esophagus-now/fpga-bpf/Reference/Figures/BPF CPU Datapath.png

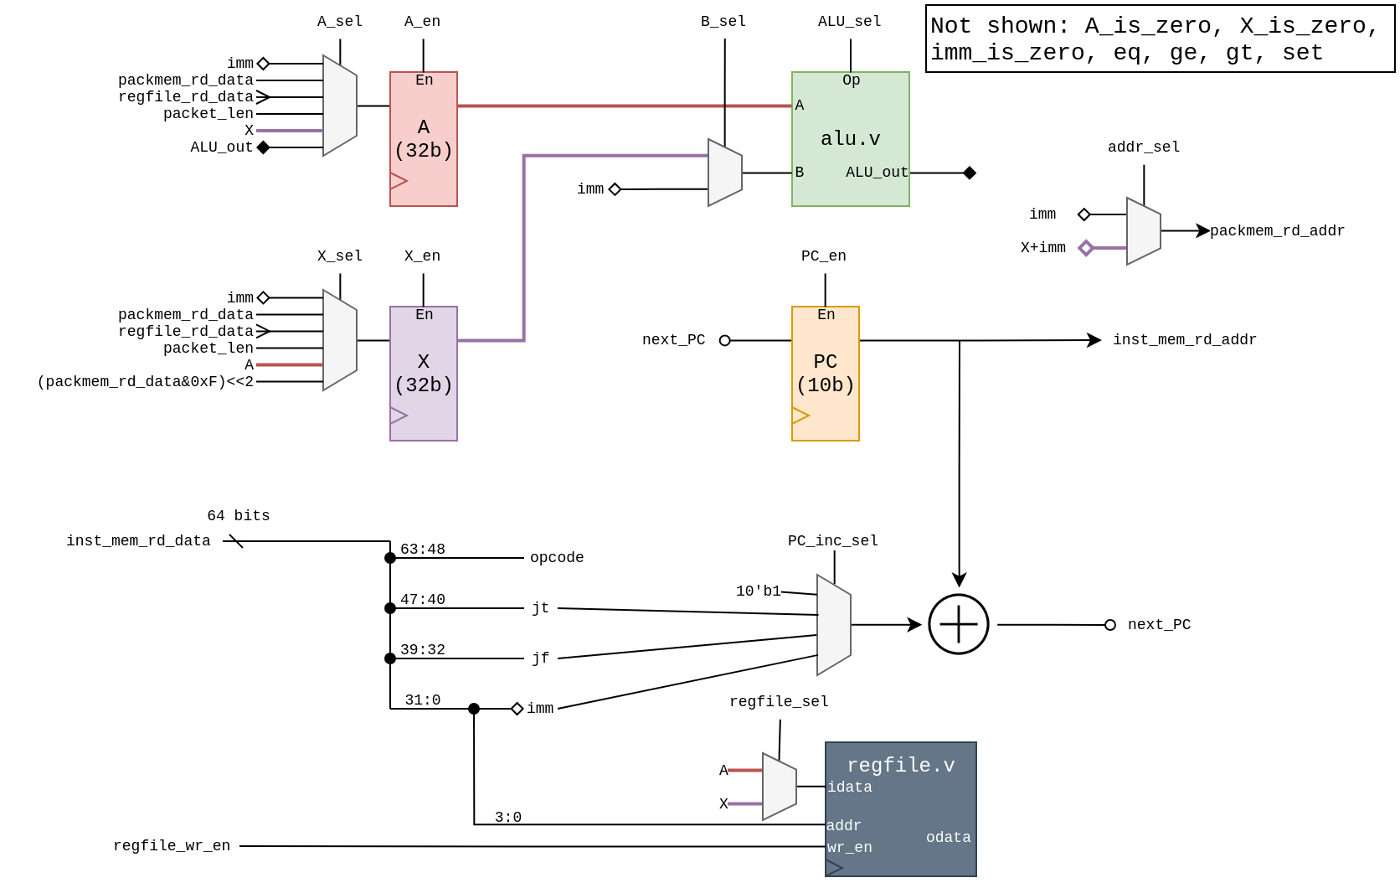
Reference/Figures/BPF CPU Datapath.png
