esophagus-now/fpga-bpf/Reference/Figures/BPF CPU State diagram.png

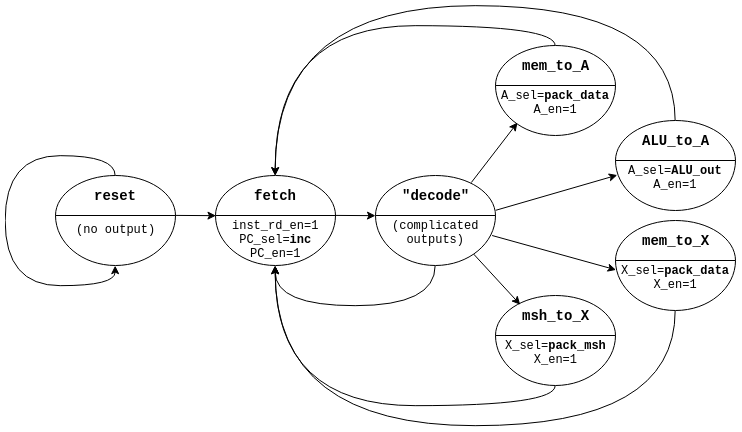
Reference/Figures/BPF CPU State diagram.png
