esophagus-now/fpga-bpf/Reference/Figures/Channel-level pipeline.png

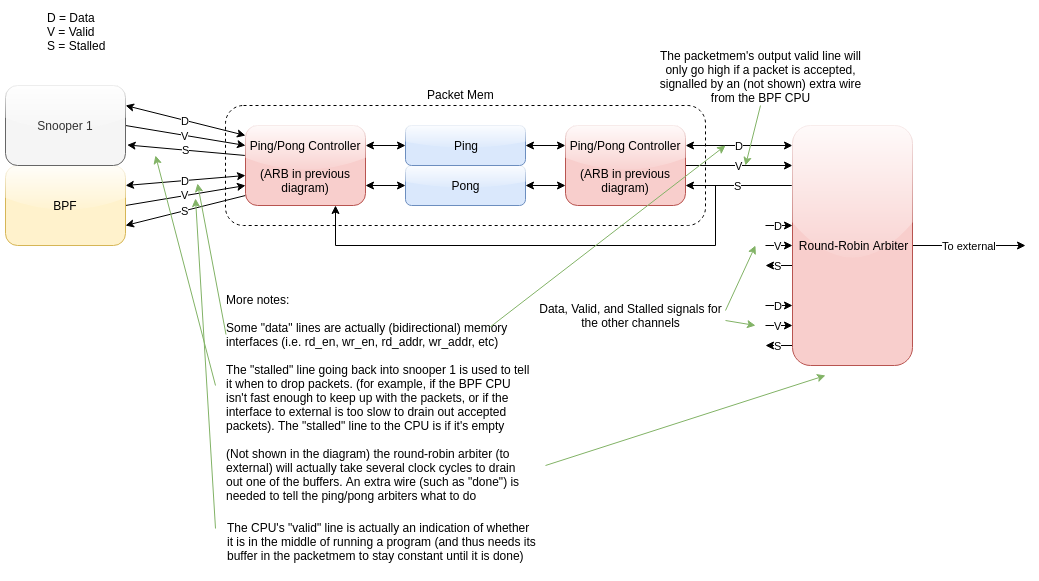
Reference/Figures/Channel-level pipeline.png
