esophagus-now/fpga-bpf/Reference/Figures/Job Queues.png

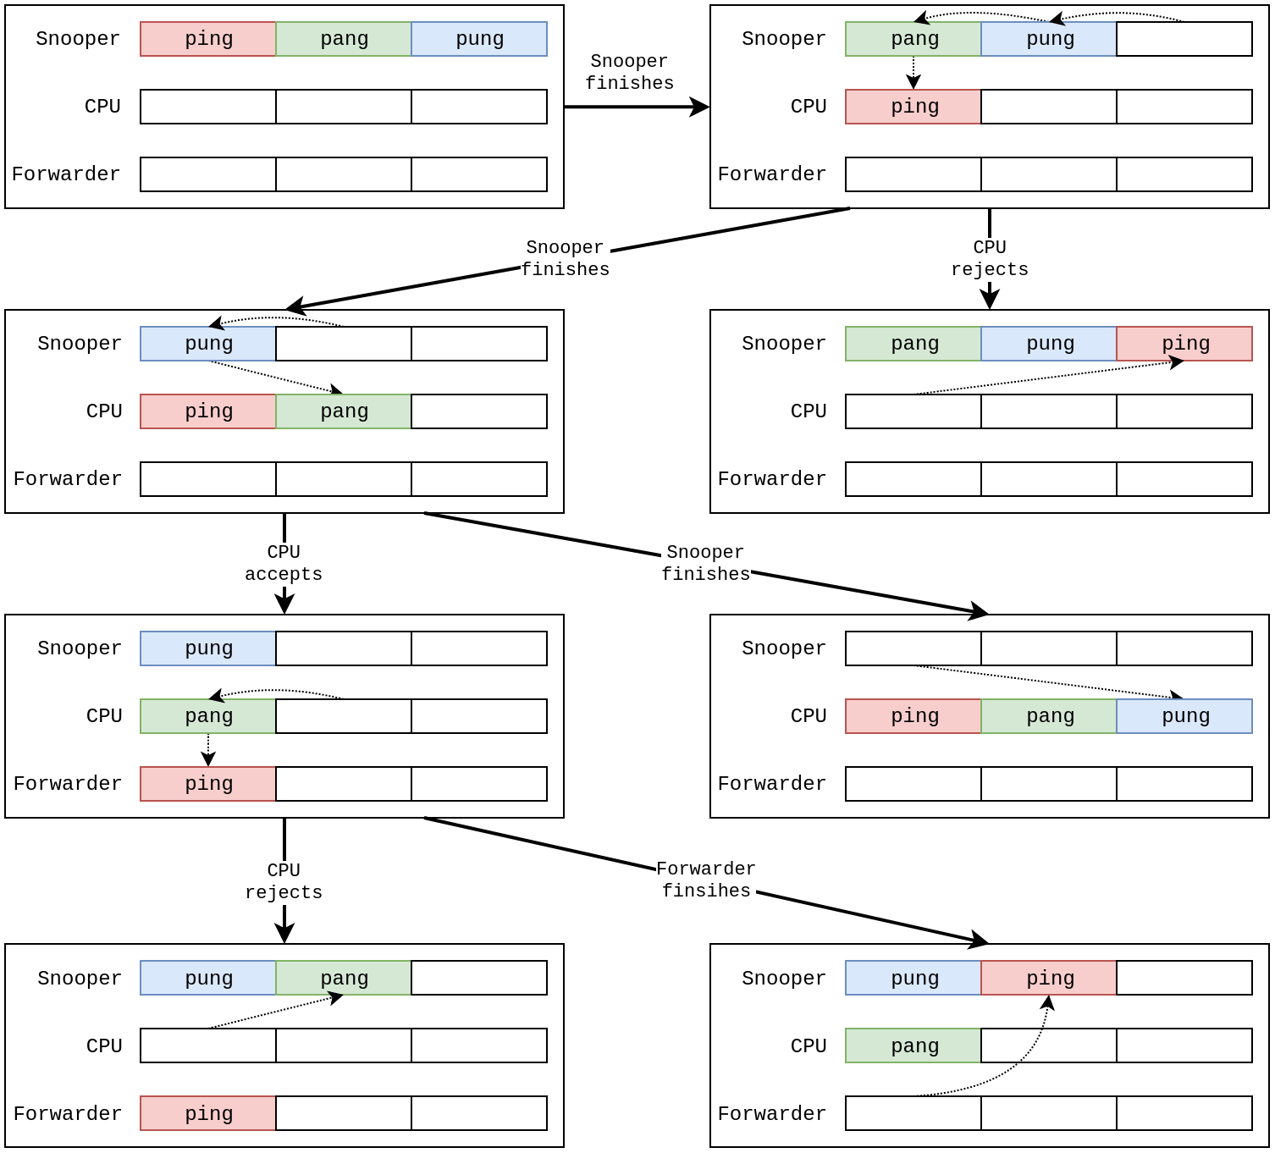
Reference/Figures/Job Queues.png
