esophagus-now/fpga-bpf/Reference/Figures/pingpangpung.png

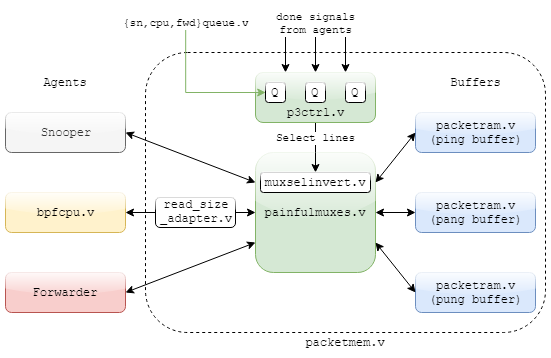
Reference/Figures/pingpangpung.png
