esophagus-now/fpga-bpf/Reference/Figures/System-level DFG.png

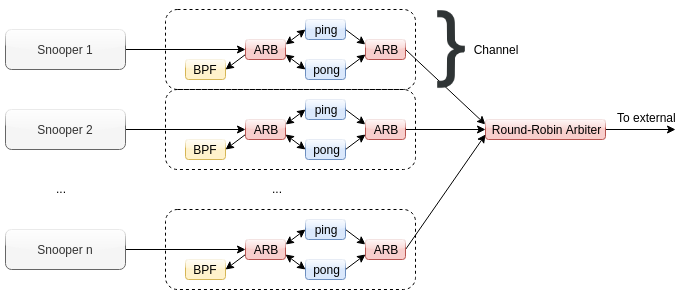
Reference/Figures/System-level DFG.png
