esophagus-now/fpga-bpf/Reference/Figures/Verilog Modules.png

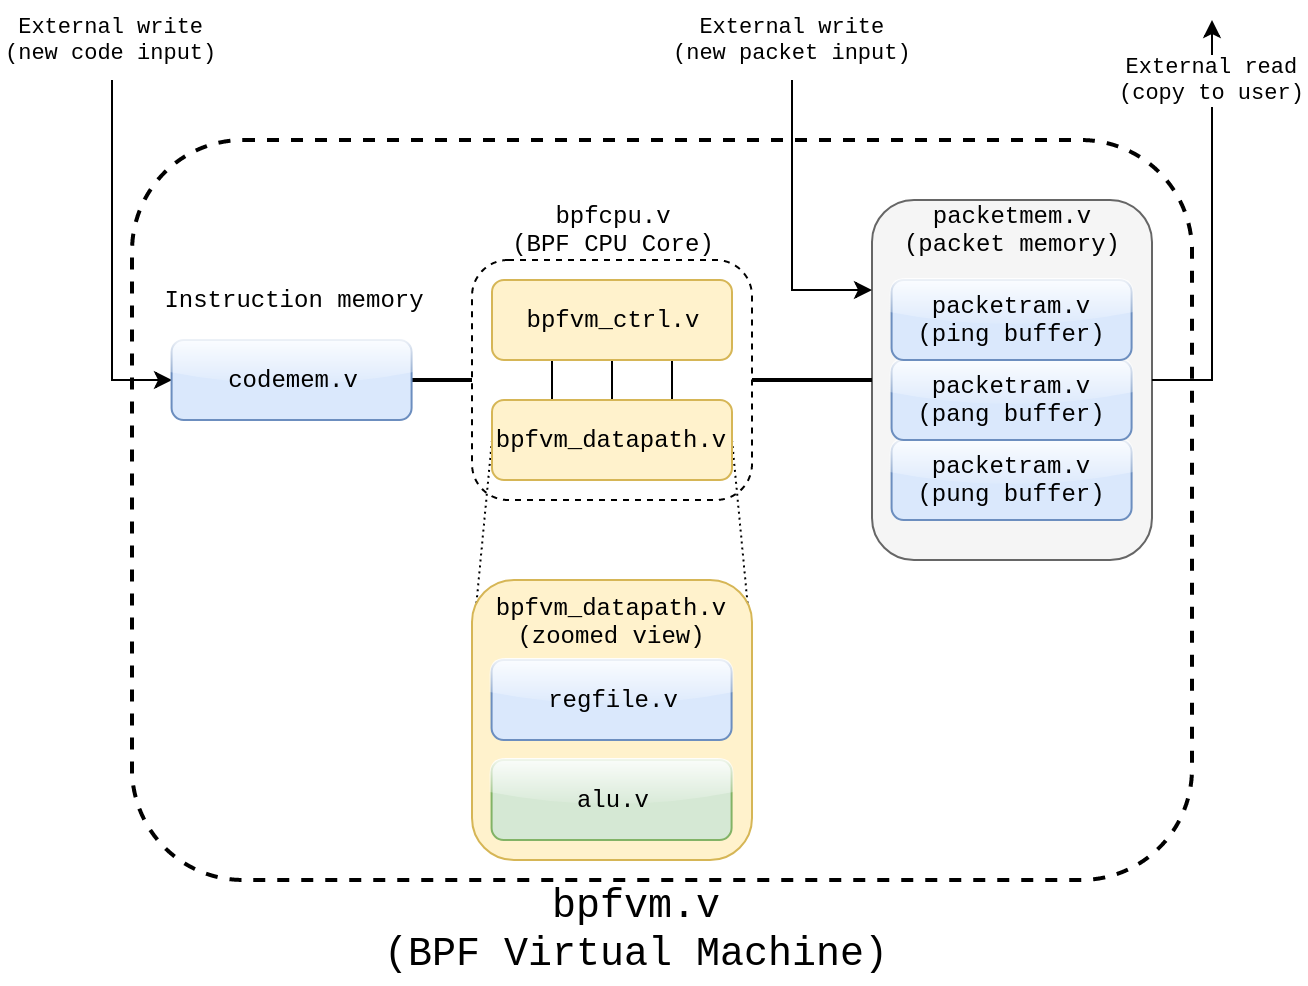
Reference/Figures/Verilog Modules.png
