esophagus-now/fpga-bpf/IPs/packetfilt/packetfilt.srcs/sources_1/imports/Sources/BPFVM/packetmem/p3ctrl/p3ctrl.v

`timescale 1ns / 1ps
/*
ppp.sv

This is a "ping-pang-pung" controller. The idea is as follows:
We have three agents that all need to share memory. To make it possible
for all three to run concurrently, we need three buffers. 

In a ping-pong scheme, the controller is fairly simple. Say the agents are
named A and B, and the buffers are name Ping and Pong. Say Ping is being
controlled by A, and Pong is being controlled by B. If A finishes its work,
it gets disconnected from Ping and we wait for B to finish. Once B finishes,
then we wire B to Ping and A to Pong and both can start. (If they finish at
the same time, we skip the states where A waits for B).

However, in a ping-pang-pung scheme, the controller is significantly more
complicated. Suppose the connections are (A-ping), (B-pang), (C-pung). Now
if B finishes first, we have to wait for C to finish. But when C finishes,
we have to wait for A to finish? And what if A finishes before C?
Yes, we both know what should happen in these cases, but writing something
in Verilog to deal with all this spaghetti logic (while trying to keep it
reasonably simple/performant/easy to debug) is quite challenging.

So here is the strategy:

Each agent (in our specific case, the snooper, CPU, and forwarder) will 
have a queue of "jobs" (i.e. [pointers to] buffers to operate on). When one 
agent is finished (e.g. the snooper) it will enqueue [a pointer to] the buffer 
it has just processed to the jobs on the next agent's queue (e.g. the CPU).

For this purpose, I wrote up snqueue.v, cpuqueue.v, and fwdqueue.v. They are
the aforementioned "job queues".

This module is intended to be used to generate the select lines on the MUXes
in packetmem.v (in order to wire up certain packetrams to certain agents).
*/

module p3_ctrl(
	input wire clk,
	input wire rst,
	input wire A_done,
	input wire B_acc, //Special case for me: B can "accept" a memory buffer and send it to C
	input wire B_rej, //or it can "reject" it and send it back to A
	input wire C_done,
	
	output wire [1:0] sn_sel,
	output wire [1:0] cpu_sel,
	output wire [1:0] fwd_sel
);

snqueue snq(
	.clk(clk),
	.rst(rst),
	.token_from_cpu(cpu_sel),
	.en_from_cpu(B_rej),
	.token_from_fwd(fwd_sel),
	.en_from_fwd(C_done),
	.deq(A_done),
	.head(sn_sel)
);

cpuqueue cpuq(
	.clk(clk),
	.rst(rst),
	.token_from_sn(sn_sel),
	.en_from_sn(A_done),
	.deq(B_acc | B_rej),
	.head(cpu_sel)
);

fwdqueue fwdq (
	.clk(clk),
	.rst(rst),
	.token_from_cpu(cpu_sel),
	.en_from_cpu(B_acc),
	.deq(C_done),
	.head(fwd_sel)
);

endmodule
