esophagus-now/fpga-bpf/Testbenches/bpfvmtb.sv

`timescale 1ns / 1ps
/*
bpfvmtb.sv

A testbench for the bpfvm block diagram. Sadly, I don't know how to properly add
a block diagram into a repo. So, for the time being, I'll describe what it is:

Simply put, the bpfvm_datapath and bpfvm_ctrl are wired together in the obvious
way (i.e. connect matching signal names). Then, instantiate one packetmem and one
codemem, and connect the memory read inputs to the remaining outputs of the datapath
and controller. Finally, make all the memory write inputs (aswell as clock and rest)
external.
*/

//I don't really know how to properly upload block diagrams to github, so this file
//uses the following `define to switch between compatibility with bpfvm.v, or with 
//my block diagram in IP integrator

//`define USING_BLOCK_DIAGRAM
//Comment this out if you're just trying to simulate bpfvm.v

/*
First, a bunch of defines to make the code easier to deal with.
These were taken from the BPF reference implementation, and
modified to match Verilog's syntax
*/
/* instruction classes */
`ifndef BPF_LD
`define		BPF_LD		3'b000
`define		BPF_LDX		3'b001
`define		BPF_ST		3'b010
`define		BPF_STX		3'b011
`define		BPF_ALU		3'b100
`define		BPF_JMP		3'b101
`define		BPF_RET		3'b110
`define		BPF_MISC	3'b111

/* ld/ldx fields */
//Fetch size 
`define		BPF_W		2'b00 //Word, half-word, and byte
`define		BPF_H		2'b01
`define		BPF_B		2'b10
//Addressing mode
`define		BPF_IMM 	3'b000 
`define		BPF_ABS		3'b001
`define		BPF_IND		3'b010 
`define		BPF_MEM		3'b011
`define		BPF_LEN		3'b100
`define		BPF_MSH		3'b101
//ALU operation select
`define		BPF_ADD		4'b0000
`define		BPF_SUB		4'b0001
`define		BPF_MUL		4'b0010
`define		BPF_DIV		4'b0011
`define		BPF_OR		4'b0100
`define		BPF_AND		4'b0101
`define		BPF_LSH		4'b0110
`define		BPF_RSH		4'b0111
`define		BPF_NEG		4'b1000
`define		BPF_MOD		4'b1001
`define		BPF_XOR		4'b1010
//Jump types
`define		BPF_JA		3'b000
`define		BPF_JEQ		3'b001
`define		BPF_JGT		3'b010
`define		BPF_JGE		3'b011
`define		BPF_JSET	3'b100
//Compare-to value select
`define		BPF_COMP_IMM	1'b0
`define 	BPF_COMP_X		1'b1
//Return register select
`define		RET_IMM		2'b00
`define		RET_X		2'b01
`define		RET_A		2'b10

`define CODE_ADDR_WIDTH 10
`define CODE_DATA_WIDTH 64 
`define PACKET_BYTE_ADDR_WIDTH 12
`define PACKET_ADDR_WIDTH (`PACKET_BYTE_ADDR_WIDTH - 2)
`define PACKET_DATA_WIDTH 32

`endif

module bpfvmtb();

reg rst;
reg clk;

//Interface to an external module which will fill codemem
reg [`CODE_ADDR_WIDTH-1:0] code_mem_wr_addr;
reg [`CODE_DATA_WIDTH-1:0] code_mem_wr_data;
reg code_mem_wr_en;

//Interface to snooper
reg [`PACKET_ADDR_WIDTH-1:0] snooper_wr_addr;
reg [31:0] snooper_wr_data; //Hardcoded to 32 bits. TODO: change this to 64?
reg snooper_wr_en;
reg snooper_done; //NOTE: this must be a 1-cycle pulse.
wire ready_for_snooper;

//Interface to forwarder
reg [`PACKET_ADDR_WIDTH-1:0] forwarder_rd_addr;
wire [63:0] forwarder_rd_data;
reg forwarder_rd_en;
reg forwarder_done; //NOTE: this must be a 1-cycle pulse.
wire ready_for_forwarder;

task snoopwr;
input [31:0] dat;
begin
	wait(clk == 0);
	snooper_wr_en = 1;
	snooper_wr_data = dat;
	@(negedge clk);
	snooper_wr_en = 0;
	snooper_wr_addr = snooper_wr_addr + 1;
end
endtask

task codewr;
input [63:0] dat;
begin
	wait(clk == 0);
	code_mem_wr_en = 1;
	code_mem_wr_data = dat;
	@(negedge clk);
	code_mem_wr_en = 0;
	code_mem_wr_addr = code_mem_wr_addr + 1;
end
endtask

event write_rejectable_packet, write_rejectable_packet_done;
event write_acceptable_packet, write_acceptable_packet_done;
event fill_code_mem, fill_code_mem_done;

initial forever begin
	@(fill_code_mem);
	
	code_mem_wr_addr = 0;
	
	codewr({8'h0, `BPF_ABS, `BPF_H, `BPF_LD, 8'h88, 8'h88, 32'd12}); //ldh [12]                         
	codewr({8'b0, `BPF_JEQ, `BPF_COMP_IMM, `BPF_JMP, 8'd0, 8'd13, 32'h800}); //jeq #0x800 jt 2 jf 15    
	codewr({8'h0, `BPF_ABS, `BPF_B, `BPF_LD, 8'h88, 8'h88, 32'd23}); //ldb [23]                         
	codewr({8'h0, `BPF_JEQ, `BPF_COMP_IMM, `BPF_JMP, 8'd0, 8'd11, 32'h0006}); //jeq #0x6 jt 4 jf 15     
	codewr({8'h0, `BPF_ABS, `BPF_H, `BPF_LD, 8'h0, 8'h0, 32'd20}); //ldh [20]                           
	codewr({8'h0, `BPF_JSET, `BPF_COMP_IMM, `BPF_JMP, 8'd9, 8'd0, 32'h1FFF}); //jset 0x1FFF jt 15 jf 6  
	codewr({8'h0, `BPF_MSH, `BPF_B, `BPF_LDX, 8'h0, 8'h0, 32'd14}); //ldxb_msh addr 14                  
	codewr({8'h0, `BPF_IND, `BPF_H, `BPF_LD, 8'h0, 8'h0, 32'd14}); //ldh ind x+14                       
	codewr({8'h0, `BPF_JEQ, `BPF_COMP_IMM, `BPF_JMP, 8'd0, 8'd2, 32'h0064}); //jeq 0x64 jt 9 jf 11      
	codewr({8'h0, `BPF_IND, `BPF_H, `BPF_LD, 8'h0, 8'h0, 32'd16}); //ldh ind x+16                       
	codewr({8'h0, `BPF_JEQ, `BPF_COMP_IMM, `BPF_JMP, 8'd3, 8'd4, 32'h00C8}); //jeq 0xC8 jt 14 jf 15    
	codewr({8'h0, `BPF_JEQ, `BPF_COMP_IMM, `BPF_JMP, 8'd0, 8'd3, 32'h00C8}); //jeq 0xC8 jt 12 jf 15    
	codewr({8'h0, `BPF_IND, `BPF_H, `BPF_LD, 8'h0, 8'h0, 32'd16}); //ldh ind x+16                      
	codewr({8'h0, `BPF_JEQ, `BPF_COMP_IMM, `BPF_JMP, 8'd0, 8'd1, 32'h0064}); //jeq 0x64 jt 14 jf 15    
	codewr({8'h0, 3'b0, `RET_IMM,   `BPF_RET, 8'd0, 8'd0, 32'd65535}); //ret #65535                    
	codewr({8'h0, 3'b0, `RET_IMM,   `BPF_RET, 8'd0, 8'd0, 32'd0}); //ret #0                            

	->fill_code_mem_done;
end

initial forever begin
	@(write_rejectable_packet);
	
	wait(ready_for_snooper); //I'm smiling to myself as I write "snooper" everywhere
	//You know that 80s song "dreamer"? "snooooo-per!... you know you are a snooo-per!"
	snooper_wr_addr = 0;
	
	//This packet should be rejected
	snoopwr(32'hDEADBEEF);
	snoopwr(32'hBEEFCAFE);
	snoopwr(32'hCAFEDEAD);
	snoopwr(32'h01234567);
	snoopwr(32'h89ABCDEF);
	snoopwr(32'h55555555);
	snoopwr(32'hAAAAAAAA);
	snoopwr(32'h00000000);
	snoopwr(32'h11111111);
	snoopwr(32'h22222222);
	snoopwr(32'hFFFFFFFF);
	
	@(negedge clk);
	snooper_done = 1;
	@(negedge clk);
	snooper_done = 0;
	->write_rejectable_packet_done;
end


initial forever begin
	@(write_acceptable_packet);
	
	wait(ready_for_snooper); //I'm smiling to myself as I write "snooper" everywhere
	//You know that 80s song "dreamer"? "snooooo-per!... you know you are a snooo-per!"
	snooper_wr_addr = 0;
	
	//This packet should be accepted
	snoopwr(32'h70b31760);
	snoopwr(32'ha09f782b);
	snoopwr(32'hcba3f197);
	snoopwr(32'h08004500);
	snoopwr(32'h00288860);
	snoopwr(32'h00000206);
	snoopwr(32'hfd248064);
	snoopwr(32'hf13dc0a8);
	snoopwr(32'h010100c8);
	snoopwr(32'h0064acbe);
	snoopwr(32'hbdc10000);
	snoopwr(32'h00005004);
	snoopwr(32'h05c80b21);
	snoopwr(32'h0000FFFF);
	
	@(negedge clk);
	snooper_done = 1;
	@(negedge clk);
	snooper_done = 0;
	->write_acceptable_packet_done;
end

//This pretends to be a forwarder which always finishes after 50 cycles
initial forever begin
	wait(ready_for_forwarder);
	repeat (49) @(negedge clk);
	forwarder_done = 1;
	@(negedge clk);
	forwarder_done = 0;
end

initial begin
	clk <= 0;
	`ifdef USING_BLOCK_DIAGRAM
	rst <= 1;
	`else
	rst <= 0;
	`endif
	code_mem_wr_addr <= 0;
	code_mem_wr_data <= 0;
	code_mem_wr_en <= 0;
	
	snooper_wr_addr <= 0;
	snooper_wr_data <= 0;
	snooper_wr_en <= 0;
	snooper_done <= 0;
	
	forwarder_rd_addr <= 0;
	forwarder_rd_en <= 0;
	forwarder_done <= 0;
	
	//Trigger a reset
	
	`ifdef USING_BLOCK_DIAGRAM
	rst <= 0;
	`else
	rst <= 1;
	`endif
	
	#20
	
	`ifdef USING_BLOCK_DIAGRAM
	rst <= 1;
	`else
	rst <= 0;
	`endif
	
	`ifdef USING_BLOCK_DIAGRAM
	//Wait for reset time to finish
	@(negedge DUT.tle_i.bpfcpu_0.rst);
	`endif
	
	//It almost seems like the BRAM "isn't ready yet". So let's try waiting a few clock cycles while we do nothing
	repeat (20) @(negedge clk);
	
	->fill_code_mem;
	@(fill_code_mem_done);
	
	->write_rejectable_packet;
	
	@(write_rejectable_packet_done);
	->write_acceptable_packet;
	
	wait(forwarder_done);
	#40
	$finish;
end

//initial #1000 $finish;

//Implements 100 MHz clock (I think)
always #5 clk <= ~clk;

`ifdef USING_BLOCK_DIAGRAM
tle_wrapper
`else
bpfvm
`endif
DUT (
	//TODO: add proper reset signal handling
`ifdef USING_BLOCK_DIAGRAM
	.reset(rst),
	.sys_clock(clk),
`else
	.rst(rst),
	.clk(clk),
`endif
	//Interface to an external module which will fill codemem
	.code_mem_wr_addr(code_mem_wr_addr),
	.code_mem_wr_data(code_mem_wr_data),
	.code_mem_wr_en(code_mem_wr_en),
    
    //Interface to snooper
	.snooper_wr_addr(snooper_wr_addr),
	.snooper_wr_data(snooper_wr_data), //Hardcoded to 32 bits. TODO: change this to 64?
	.snooper_wr_en(snooper_wr_en),
	.snooper_done(snooper_done), //NOTE: this must be a 1-cycle pulse.
	.ready_for_snooper(ready_for_snooper),
    
	//Interface to forwarder
	.forwarder_rd_addr(forwarder_rd_addr),
	.forwarder_rd_data(forwarder_rd_data),
	.forwarder_rd_en(forwarder_rd_en),
	.forwarder_done(forwarder_done), //NOTE: this must be a 1-cycle pulse.
	.ready_for_forwarder(ready_for_forwarder)
);

endmodule
