esophagus-now/fpga-bpf/(commit log)

2019-07-30 Synchronized packetmem, also fixed offsetting and stuff
    [packetmem.v, packetmemtb.sv]
2019-08-04 Added kmaps for muxselinvert
    [kmaps.csv]
2019-08-05 Added extremely basic testbench file for final assembly
2019-08-06 Updated testbench, a couple minor fixes
    [bpfvmtb.sv]
2019-08-06 Fixed like 1 bug in the BPFVM, and like 10 typos from me manually assembling the BPF code. It works!
    [bpfvmtb.sv]
2019-08-07 Postsynth functional sim doesn't work and I don't know why. Also went through and dealt with synth warnings, but to no avail
    [bpfcpu.v, bpfvm.v, bpfvmtb.sv, p3ctrl.v, packetmem.v, packetmemtb.sv]
2019-08-08 Fixed warning about using 'reject' as a port name. Also, found the bug in the postsynth functional sim; you need to wait for the BRAM to "warm up"
    [bpfcpu.v, bpfvm.v, bpfvmtb.sv]
2019-08-09 It passes the port-implementation timing sim. Turns out that my problems were because I was too careless with resets; the design was actually fine
    [bpfvmtb.sv]
2019-08-13 Fixed a few bugs;p it should be ready now
    [bpfvmtb.sv, packetram.v]
2019-08-14 In the middle of writing a testbench for the final assembly.
2019-08-15 Finished the sim. Turns out there were some "pointer arithmetic" bugs, but now it passes
    Note to self: my solution was kind of a kludge. I fiddled with wires in packetmem.v to
    divide the forwader's address by 2, but I divided the packet length by 2 inside my
    test forwarder. What's more is that the length is in words, not bytes, so I might need
    to do some kind of fix for the CPU as well... and all this just makes me think that I
    don't have a way to collect packets that are a weird number of bits (like 731 or
    something).
    Oh... what am I getting into?
    [axistream_forwarder.v, packetmem.v]
2019-08-20 Added hardware test stuff, and fixed a bug in forwarder I forgot that TLAST also had to be delayed in the axistream_forwarder. Also, I made a simple Verilog module to generate fake data for the snoop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
    [axistream_forwarder.v, bpfcpu.v, coderam.v, fakedata.v, fakedatatb.sv]
2019-08-22 Deleted packaged IPs; most were broken anyway
    [axistream_forwarder.v, axistream_snooper.v, bpfcpu.v, bpfvm.v, codemem.v, coderam.v, p3ctrl.v]
2019-08-22 In the middle of testing my new AXI infrastructure I moved the reg+strobe logic to a new module and made a testbench for it. It looks good. I haven't done a timing simulation yet.
    I'm still in the middle of figureing out the easiest way to test the AXI register file
    stuff. I may try instantiating an AXI VIP in a testbench (that way I can include the
    testing code in the git repo). Aside from doing it the block diagram way, the other
    options would be to manually twiddle the AXI wires (yuck) or write an HLS core that
    drives the inputs (also yuck, but may be easier than the manual way).
2019-08-23 A ton of little things to do with AXI Stream packet filt First, I added Testbenches/axistream_packetfilt_tb.sv. This file is a testbench for a block design that is not present in the repo. Running th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
    Second, as a consquence to writing that testbench, I had to extend fakedata to have a
    TLAST signal.
    Third, I added a timescale command to the AirHDL files to get rid of a warning.
    [fakedata.v, regstrb2mem.v]
2019-08-23 Added packaged IP for axistream packet filter
2019-08-23 Typo fix in packetmem.v and bpfvm_ctrl.v
    [packetmem.v]
2019-08-23 Applied bug fixes to packaged IP
    [packetmem.v, read_size_adapter.v]
2019-08-24 Fixed relative file reference problem in packaged IP. Also removed interface port (which was causing annoyin warnings)
    [read_size_adapter.v]
2019-08-26 Marked some important wires in the IP for debug, and tracked down a really insidious problem with the AirHDL core
    [codemem.v, packetmem.v, regstrb2mem.v]
2019-08-27 Added hand-assembled tcp port 100 and 200 program
    Hand-assembled code, so may be wrong. Anyway, I know that program accepted the middle packet from fakedata.v, whereas the compiled version doesn't. So I want to double check that the CPU is still functioning as intended.
2019-09-07 A ton of minor bug fixes First, the super messy packet length logic gave me some trouble. I knew I should have just done it properly to begin with. Anyway, it's a little more consistent now.
    There was also a typo in my test data for the sim. When I was expanding
    it out to 64 bits, I forgot to set TLAST somewhere and the accepted
    packet included a bunch of deadbeef stuff.
    There may still be a few bugs to iron out, so I'm gonna take another look
    [axistream_forwarder.v, axistream_packetfilt.v, bpfcpu.v, bpfvm.v, packetmem.v, packetram.v, painfulmuxes.v]
2019-09-07 For some reason last forwarder flit is overwritten with zero, so I've intentionally caused it to read too much
    [axistream_forwarder.v]
2019-09-08 Fixed another bug with bus widths?
    [axistream_packetfilt.v, regstrb2mem.v]
2019-09-21 Started working on splitting/combining, and fixed an annoyance to do with include paths
    [coderam.v, read_size_adapter.v, snoopsplit.v]
2019-09-22 I might have fixed all the remaining bugs
    [packetram.v, read_size_adapter.v]
2019-09-22 Found (and fixed) a bunch more bugs
    [axistream_packetfilt.v, bpfvm.v, packetmem.v, painfulmuxes.v, read_size_adapter.v]
2019-09-22 Ran sim on larger data width. Passes now after fixing a few minor bugs
    [axistream_forwarder.v]
2019-09-26 Added testbench for special FIFO, and fixed bugs
    [snoopsplit.v, snoopsplit_tb.sv]
2019-09-26 Fixed tiny (but fatal) bug involving having LHS and RHS backwards in an assign statement
    [axistream_packetfilt.v, parallel_packetfilts.v, snoopsplit.v]
2019-09-26 Packaged improved filter into an IP, and left the old one just in case
2019-09-27 Quick-n-dirty fix for long comb'l paths
    [axistream_forwarder.v, axistream_snooper.v]
2019-09-27 Fixed last failing endpoint, and a typo in ALU
    [bpfcpu.v]
2019-09-27 Re-packaged the (much) improved packet filter
2019-09-28 Finished draft for stage1
2019-09-29 Fixed a couple problems with stage1 (still not tested in sim)
    [compute2_stage2.v, decode_compute1_stage1.v]
2019-09-29 Finished a draft of the stages
2019-09-29 Added valid logic in pipeline, and fixed a few wire-width typos
    [bpfvm.v, compute2_stage2.v, decode_compute1_stage1.v, fetch_stage0.v, pipelined_bpfcpu.v, pipelined_bpfvm_ctrl.v, writeback_stage3.v]
2019-09-29 Fixed all synthesis warnings
    [compute2_stage2.v, pipelined_bpfcpu.v, pipelined_bpfvm_ctrl.v]
2019-09-30 Enabled a pessimism, which adds an IDLE stage in the pipeline for all packet RAM reads. Now to see if it passes timing...
2019-10-01 I might have fixed snoopsplit timing issues. Still need to apply fix to fwdcomb
    [packetmem.v, parallel_packetfilts.v, snoopsplit.v, snoopsplit_tb.sv]
2019-10-02 Fixed minor warning with array lengths, and passes synthesis timing
    [axistream_forwarder.v, parallel_packetfilts.v]
2019-10-10 Added automatic IP packaging
    [kmaps.csv]
2019-10-17 Fixed some bugs with forwarder backpressure
    Turns out my huge sim never tested what happens when the packet
    filter is backpressured. I added a _bunch_ of really ugly patch
    fixes. This makes me very uncertain that it is completely ready...
    Anyway, at some point I'll have to sit back down and think through
    all of it properly. Basically, instead of just doing my truth
    tables for ready and valid, I should have also included last.
    [axistream_forwarder.v, axistream_forwarder_tb.sv, huge_honkin_sim.sv]
